kulerskim/gazetagrudziadzka/uchwyt-worka/img/klapka_spod.png

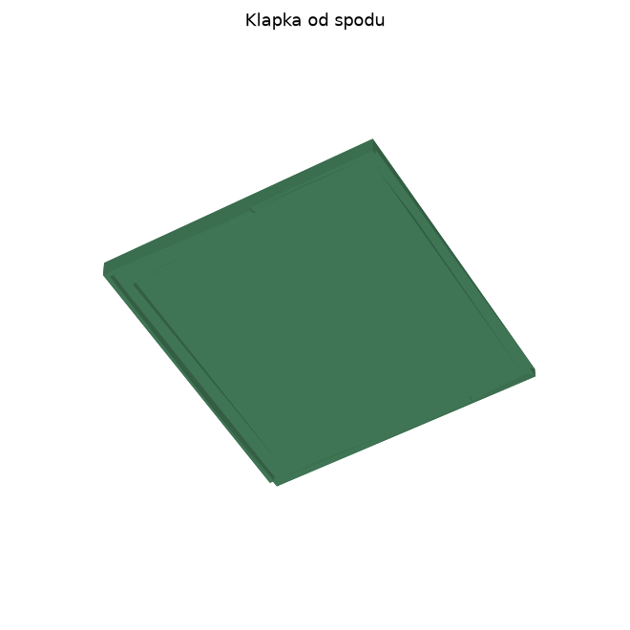
uchwyt-worka/img/klapka_spod.png
