kulerskim/gazetagrudziadzka/uchwyt-worka/img/przekroj.png

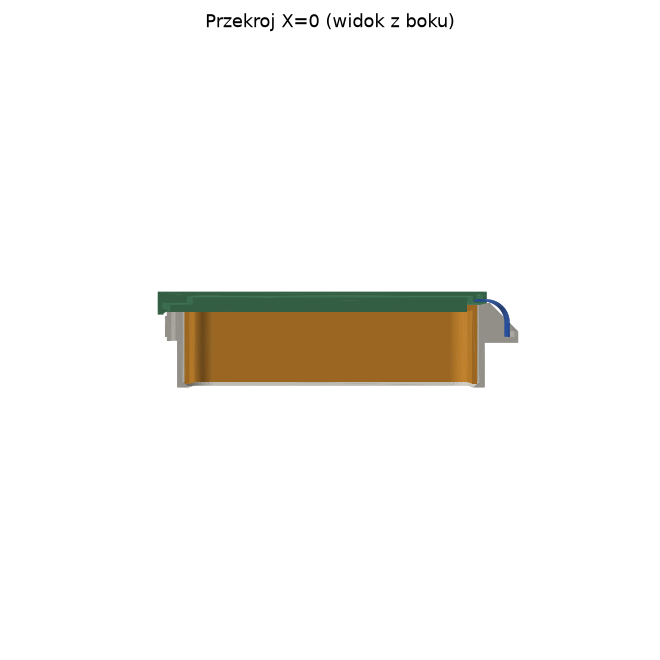
uchwyt-worka/img/przekroj.png
