kulerskim/gazetagrudziadzka/uchwyt-worka/img/przekroj_x60.png

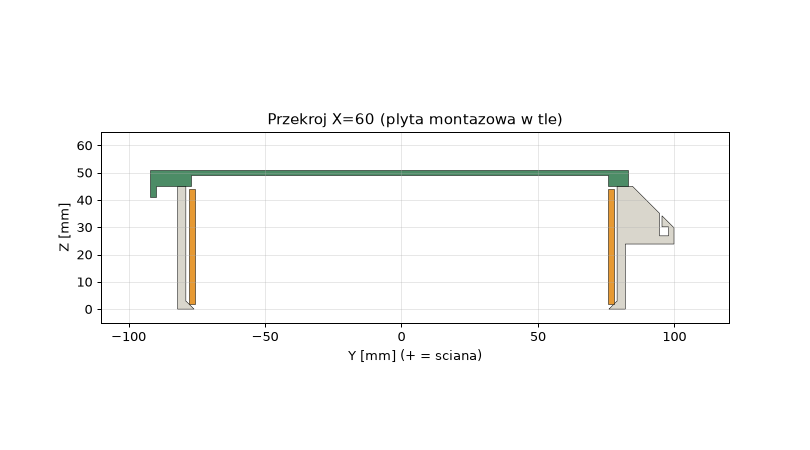
uchwyt-worka/img/przekroj_x60.png
