kulerskim/gazetagrudziadzka/uchwyt-worka/img/ramka_pierscien.png

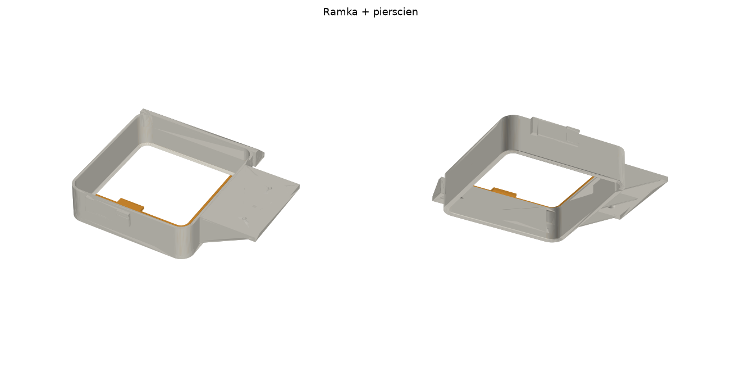
uchwyt-worka/img/ramka_pierscien.png
