kulerskim/gazetagrudziadzka/uchwyt-worka/img/zlozenie.png

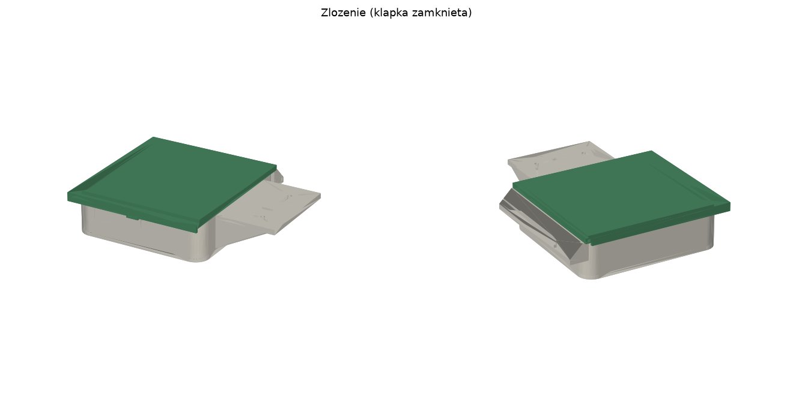
uchwyt-worka/img/zlozenie.png
