kulerskim/gazetagrudziadzka/uchwyt-worka/step/Tasma.step

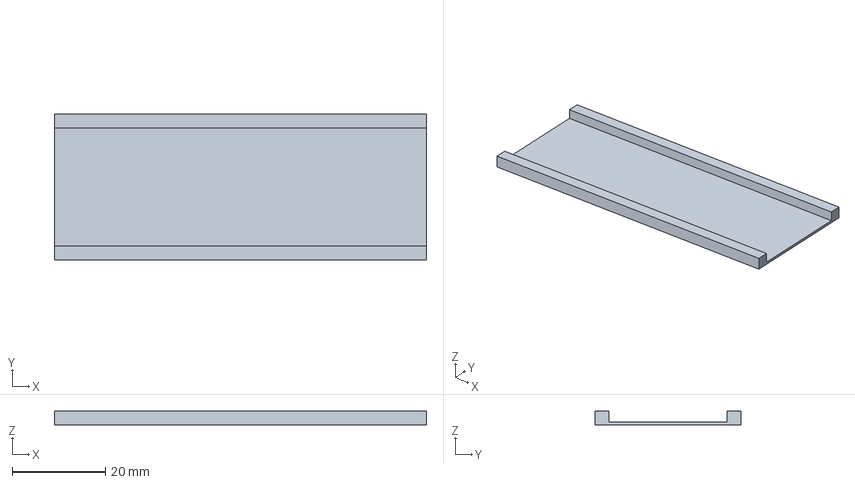
[picture p7: CAD file, 2026-09-27]
uchwyt-worka/step/Tasma.step
80.0 x 31.3 x 3.00 mm
