kulerskim/gazetagrudziadzka/uchwyt-worka/stl/testy/T1_tasma_40mm.stl

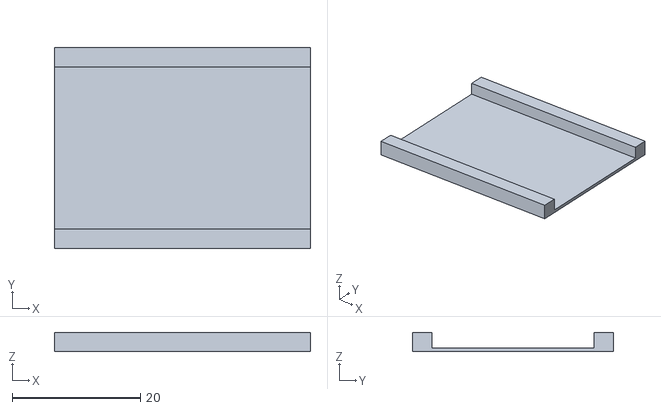
[picture p8: CAD file, 2026-09-27]
uchwyt-worka/stl/testy/T1_tasma_40mm.stl
40.0 x 31.3 x 3.00
