kulerskim/gazetagrudziadzka/uchwyt-worka/step/UchwytWorka_zlozenie.step

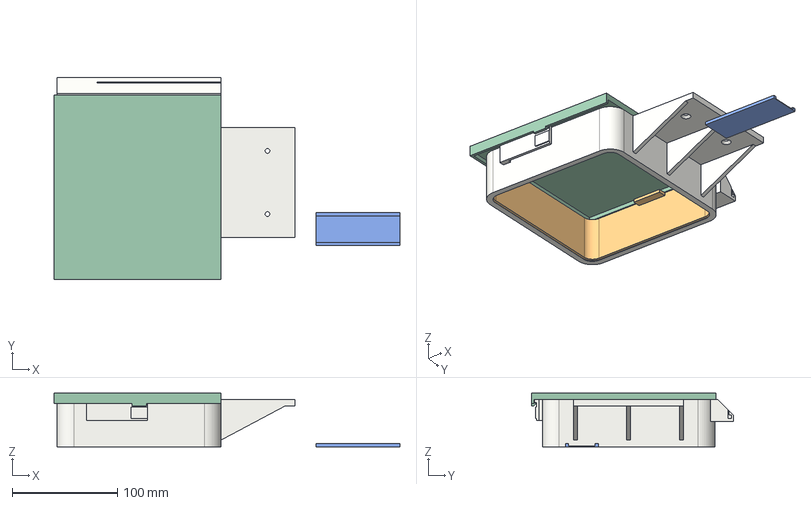
[picture p9: CAD file, 2026-09-27]
uchwyt-worka/step/UchwytWorka_zlozenie.step
329.0 x 192.1 x 51.0 mm
Ramka
Klapka
Pierscien
Tasma
