kulerskim/gazetagrudziadzka/uchwyt-worka/stl/testy/T3_worek_pierscien_12mm.stl

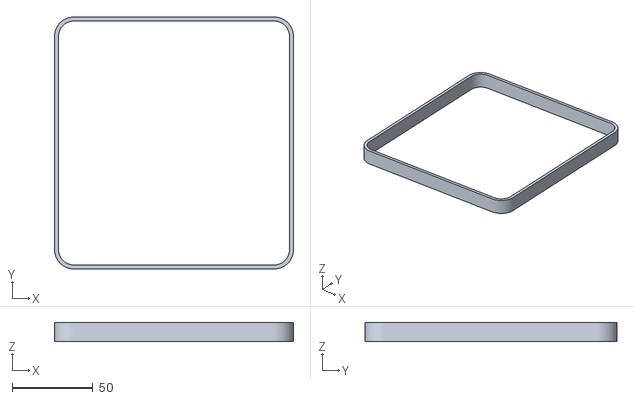
[picture p10: CAD file, 2026-09-27]
uchwyt-worka/stl/testy/T3_worek_pierscien_12mm.stl
148.0 x 156.0 x 12.0
