kulerskim/gazetagrudziadzka/uchwyt-worka/step/Klapka.step

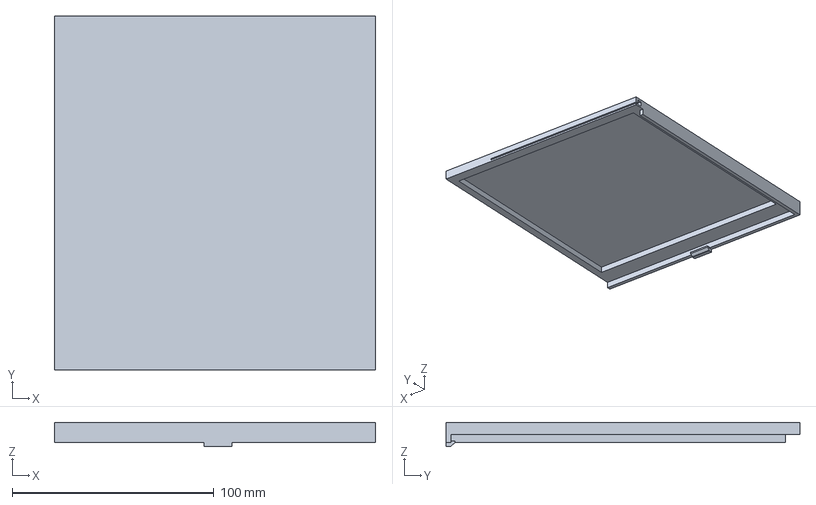
[picture p11: CAD file, 2026-09-27]
uchwyt-worka/step/Klapka.step
159.0 x 175.3 x 12.1 mm
