kulerskim/gazetagrudziadzka/uchwyt-worka/stl/testy/T1_zawias_ramka.stl

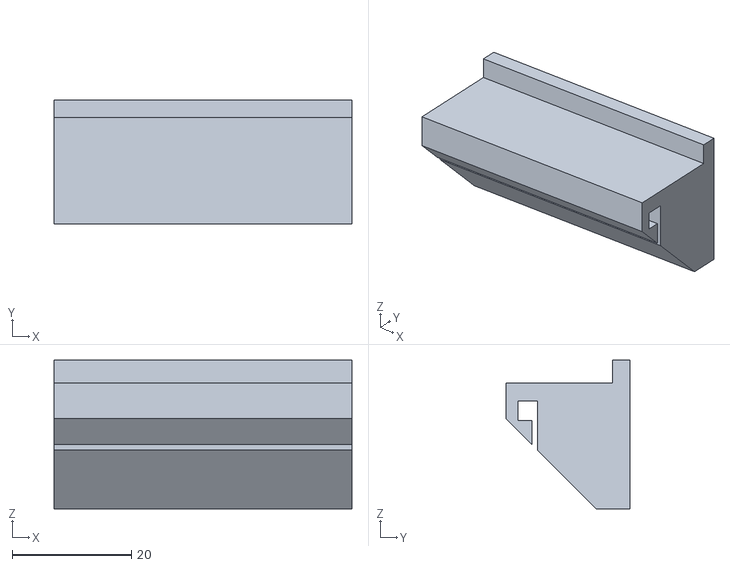
[picture p12: CAD file, 2026-09-27]
uchwyt-worka/stl/testy/T1_zawias_ramka.stl
50.0 x 20.9 x 25.0
