kulerskim/gazetagrudziadzka/uchwyt-worka/stl/testy/T2_zatrzask_ramka.stl

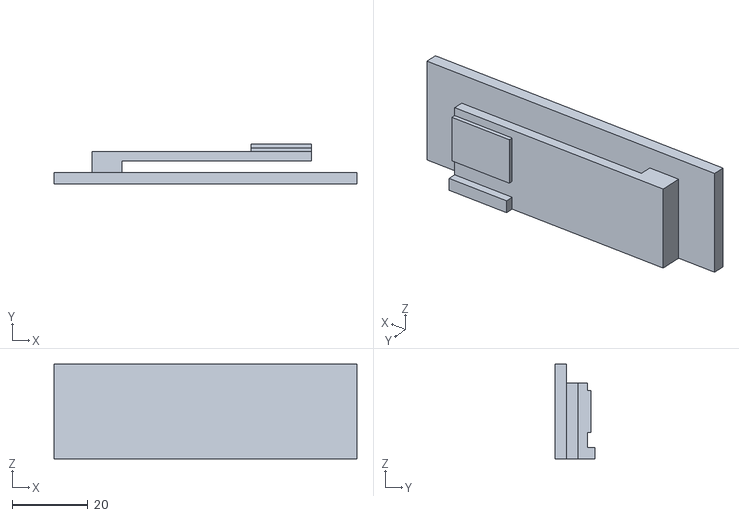
[picture p13: CAD file, 2026-09-27]
uchwyt-worka/stl/testy/T2_zatrzask_ramka.stl
80.0 x 10.5 x 25.0
