kulerskim/gazetagrudziadzka/uchwyt-worka/step/Pierscien.step

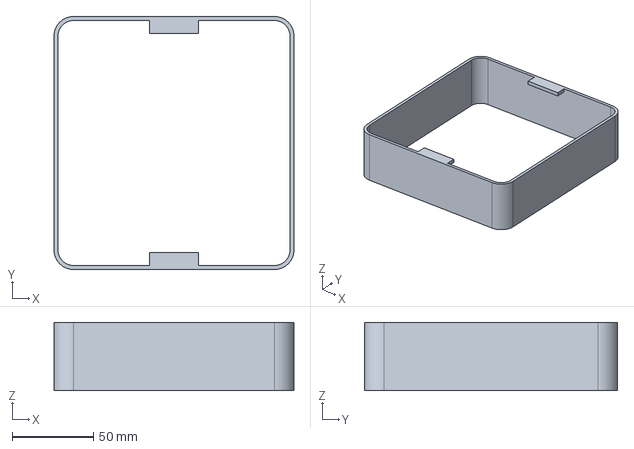
[picture p14: CAD file, 2026-09-27]
uchwyt-worka/step/Pierscien.step
148.0 x 156.0 x 42.0 mm
