kulerskim/gazetagrudziadzka/uchwyt-worka/stl/testy/T3_worek_ramka_12mm.stl

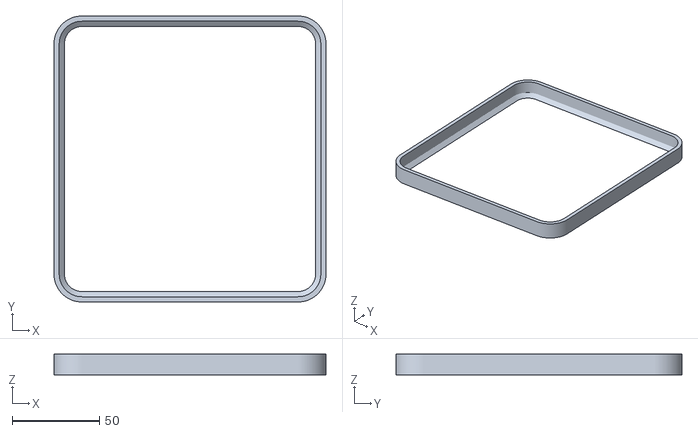
[picture p15: CAD file, 2026-09-27]
uchwyt-worka/stl/testy/T3_worek_ramka_12mm.stl
156.0 x 164.0 x 12.0
