kulerskim/gazetagrudziadzka/uchwyt-worka/step/Ramka.step

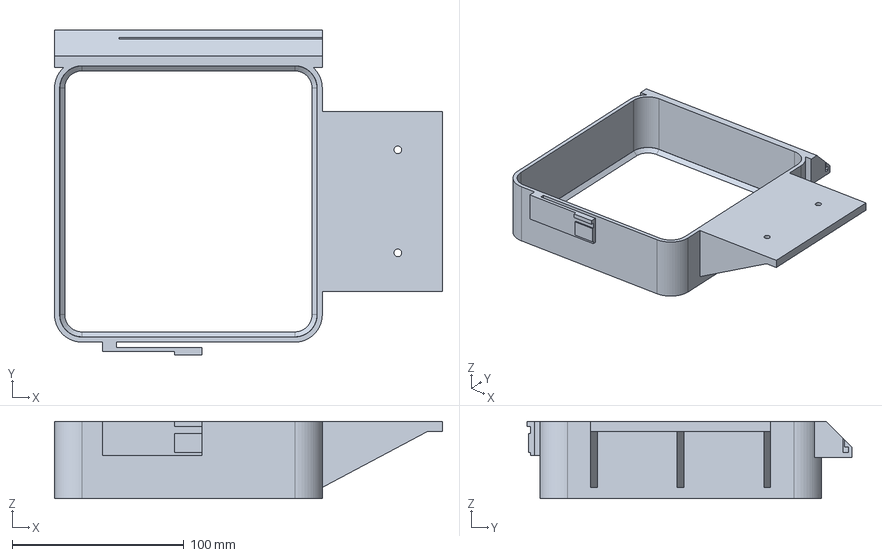
[picture p16: CAD file, 2026-09-27]
uchwyt-worka/step/Ramka.step
226.0 x 189.3 x 45.0 mm
