kulerskim/gazetagrudziadzka/uchwyt-worka/stl/testy/T2_zatrzask_klapka.stl

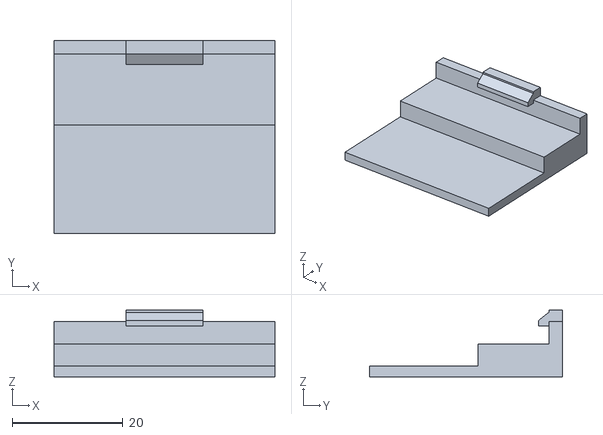
[picture p17: CAD file, 2026-09-27]
uchwyt-worka/stl/testy/T2_zatrzask_klapka.stl
40.0 x 35.0 x 12.1
