kulerskim/gazetagrudziadzka/uchwyt-worka/stl/testy/T1_zawias_klapka.stl

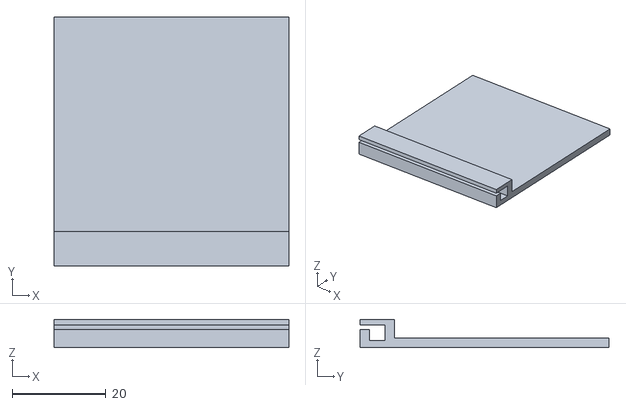
[picture p18: CAD file, 2026-09-27]
uchwyt-worka/stl/testy/T1_zawias_klapka.stl
50.0 x 53.0 x 6.00
