kulerskim/gazetagrudziadzka/(list of files, cad)

Other CAD files:
uchwyt-worka/stl/Klapka.stl
uchwyt-worka/stl/Pierscien.stl
uchwyt-worka/stl/Ramka.stl
uchwyt-worka/stl/Tasma.stl
