kulerskim/gazetagrudziadzka/uchwyt-worka/szablon/szablon_1do1.pdf

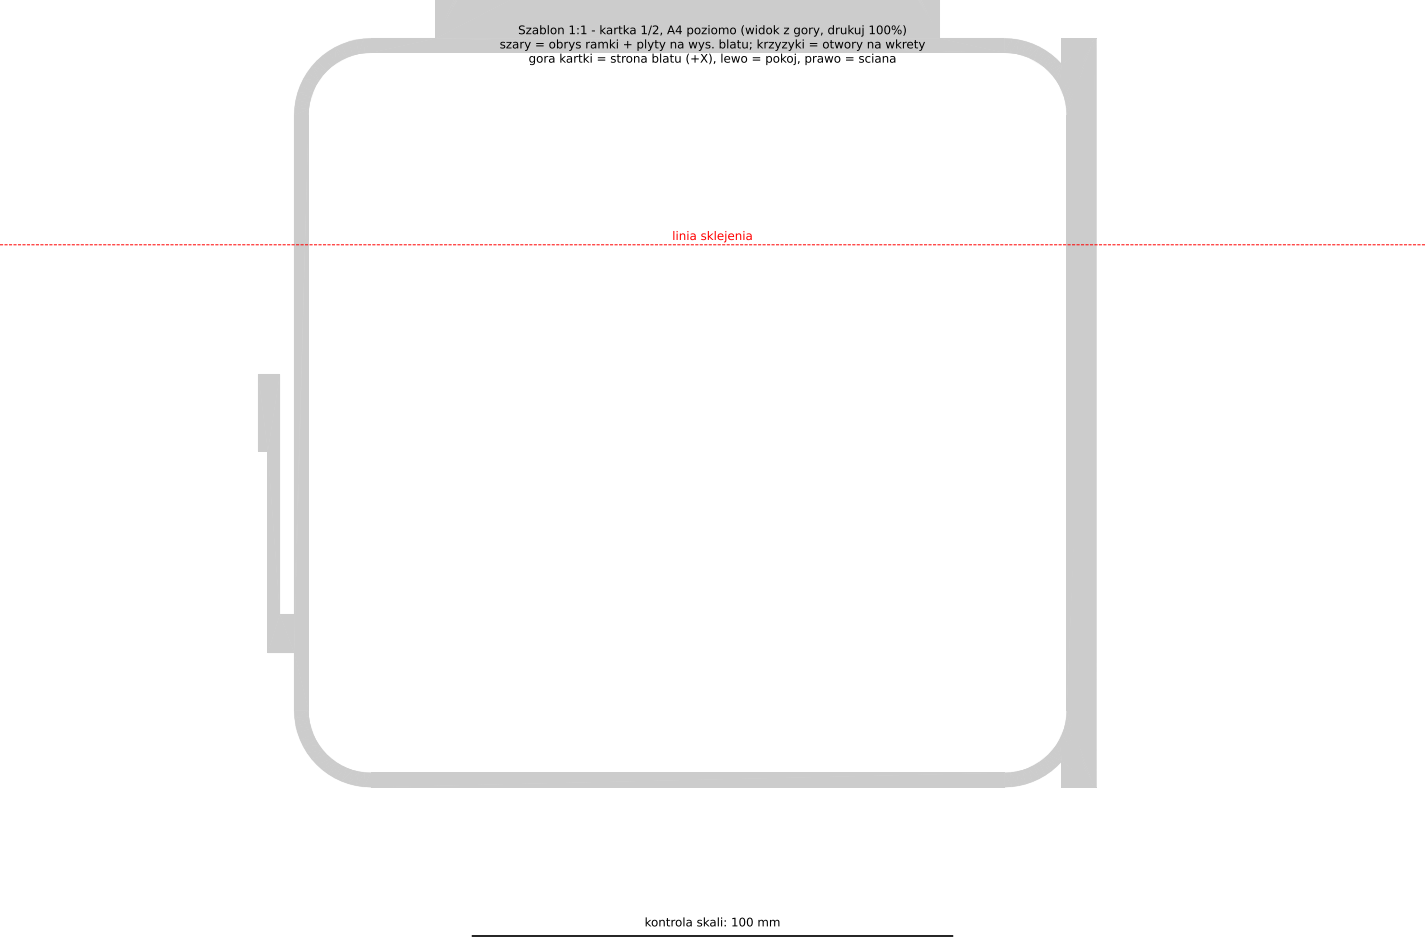
[picture p19: page 1]
linia sklejenia

Szablon 1:1 - kartka 1/2, A4 poziomo (widok z gory, drukuj 100%)
szary = obrys ramki + plyty na wys. blatu; krzyzyki = otwory na wkrety
gora kartki = strona blatu (+X), lewo = pokoj, prawo = sciana

kontrola skali: 100 mm

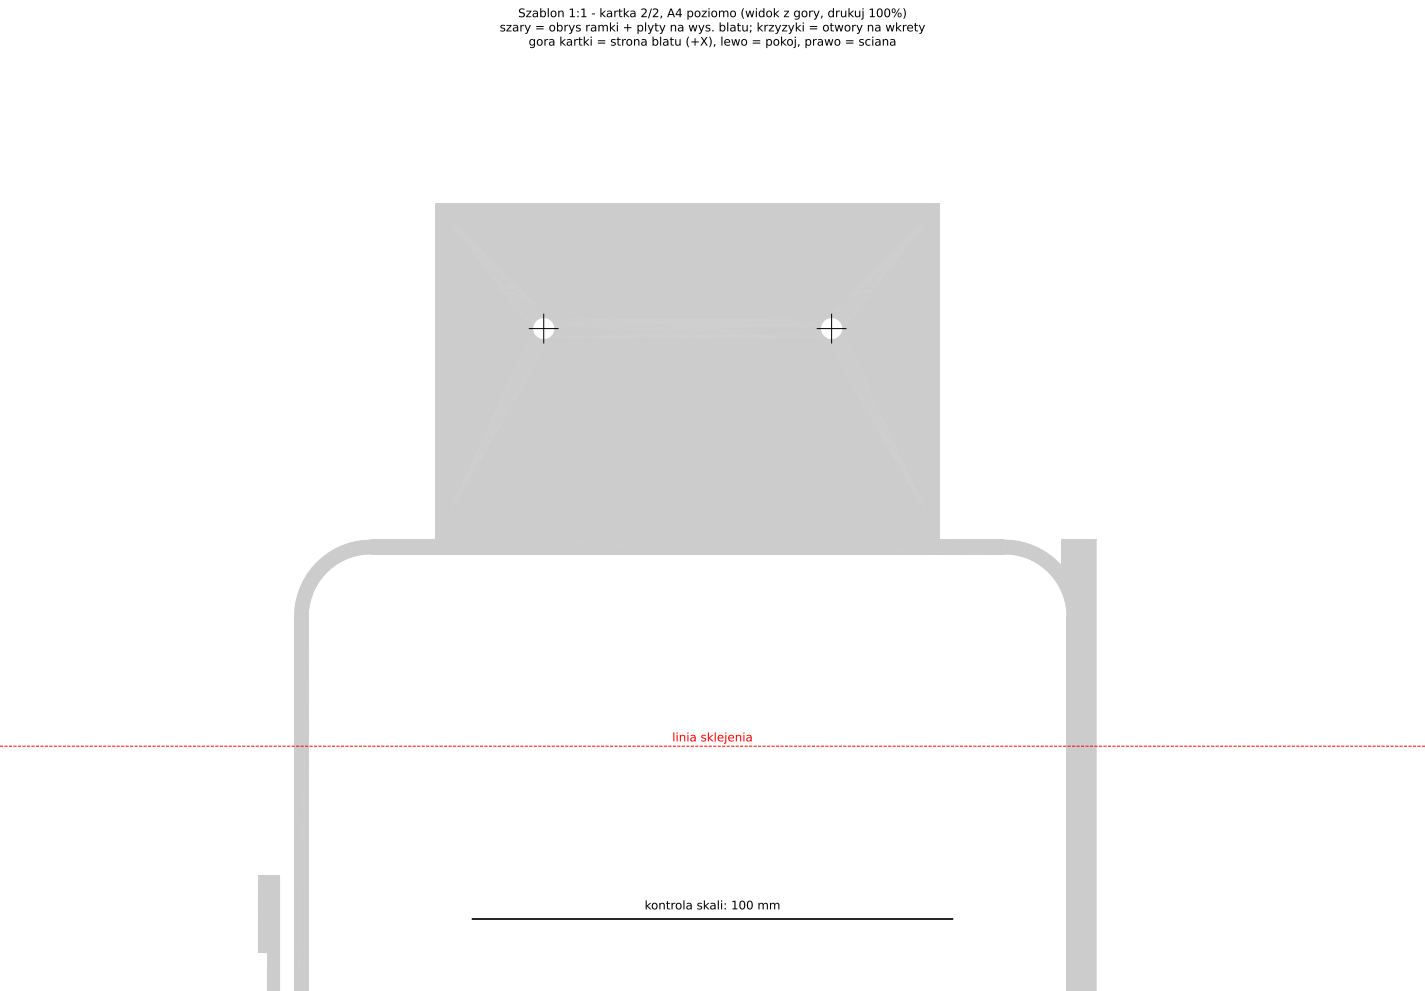
[picture p20: page 2]
linia sklejenia

Szablon 1:1 - kartka 2/2, A4 poziomo (widok z gory, drukuj 100%)
szary = obrys ramki + plyty na wys. blatu; krzyzyki = otwory na wkrety
gora kartki = strona blatu (+X), lewo = pokoj, prawo = sciana

kontrola skali: 100 mm
