kulerskim/gazetagrudziadzka/(commit log)

2026-07-28 Statyczna strona gazetagrudziadzka.pl
    Jeden plik HTML, bez JavaScriptu. Makieta projektowa — treści przykładowe,
    strona oznaczona noindex.
    Claude-Session: https://claude.ai/code/session_01DNnfwG3nvwwPzRLm4AZKhd
2026-07-31 Wydanie z piątku 31 lipca: rakieta pod Biłgorajem, Rozwój Plus, inflacja
    Temat główny: rosyjski pocisk Ch-101 nad Polską (czwartek 3.40–3.46), krater
    pod Tarnawą-Kolonią, brak ofiar. Ustalenia prokuratury, reakcja MSZ, kontekst
    nocnego ostrzału Ukrainy. Wyjaśnione, że piątkowy alert RCB to osobna sprawa,
    nie ostrzeżenie — przy samym zdarzeniu SMS-a nie wysłano, zadziałały syreny.
    Więcej polityki: klub Rozwój Plus Morawieckiego (40 posłów, 37 z PiS),
    ostatnie posiedzenie Sejmu przed wakacjami, wezwanie ambasadora Rosji.
    Gospodarka: inflacja 3,0 proc., paliwa +13,9 proc. po wygaszeniu CPN.
    Stanowiska przypisane stronom: premier, szef MSZ, prokuratura. 13 linków
    źró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
2026-09-27 Uchwyt worka na smieci z klapka: skrypt Fusion 360, STEP, STL
    Ramka z plyta montazowa pod blat, wciskany pierscien na worek, klapka
    z zawiasem-sprezyna z tasmy PETG i zatrzaskiem z przyciskiem.
    Wspolna definicja geometrii (tbh_design.py) dla skryptu Fusion 360
    i generatora CadQuery (STL/STEP).
    Claude-Session: https://claude.ai/code/session_01CPXW2KTndnQPxP99JAaFWX
    [Klapka.step, Klapka.stl, Pierscien.step, Pierscien.stl, Ramka.step, Ramka.stl, Tasma.step, Tasma.stl]
2026-09-27 Poprawka skryptu Fusion, wydruki testowe i szablon 1:1
    - usuniecie zmiany nazwy komponentu glownego (blad w Fusion 360)
    - testy.py: kupony zawiasu, zatrzasku i pasowania worka + szablon PDF
    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
    [Klapka.step, Pierscien.step, Ramka.step, T1_tasma_40mm.stl, T1_zawias_klapka.stl, T1_zawias_ramka.stl, T2_zatrzask_klapka.stl, T2_zatrzask_ramka.stl]
2026-09-27 Zmniejszenie wymiarow ok. 12% (tylko parametry rozmiaru)
    Otwor 150x158 mm, wysokosc 45 mm, plyta 70x105 mm. Czesci funkcjonalne
    (tasma, kanaly, zatrzask, otwory na wkrety) bez zmian.
    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
    [Klapka.step, Klapka.stl, Pierscien.step, Pierscien.stl, Ramka.step, Ramka.stl, T1_zawias_klapka.stl, T1_zawias_ramka.stl]
